pzfreo/purfel/stl/lower_sleeve.stl

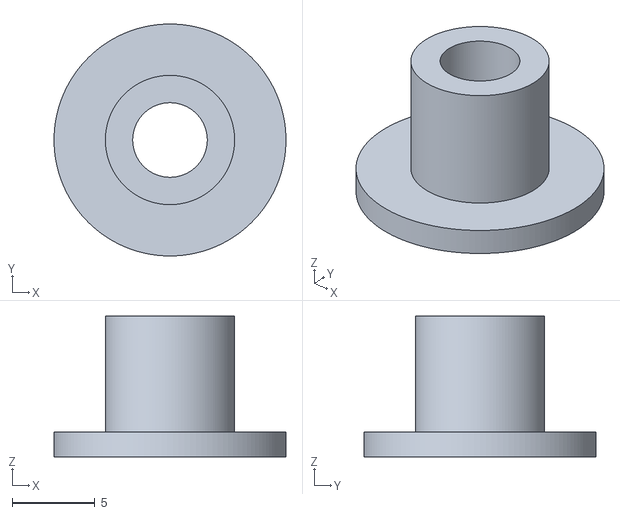
[picture p1: CAD file, 2026-04-23]
stl/lower_sleeve.stl
14.0 x 14.0 x 8.50
