pzfreo/purfel/stl/shoe.stl

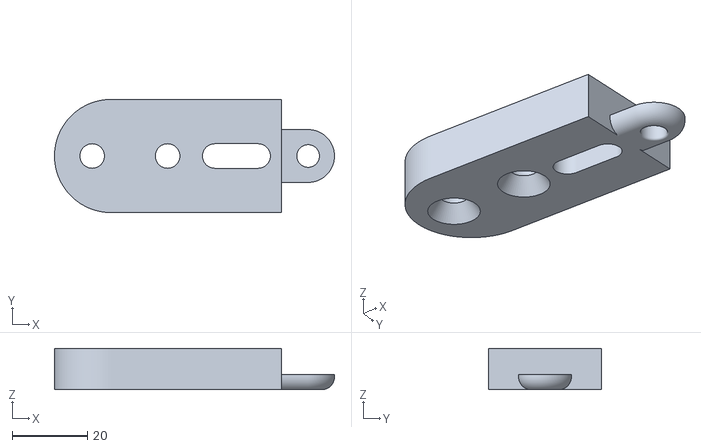
[picture p2: CAD file, 2026-04-23]
stl/shoe.stl
74.2 x 30.0 x 11.0
