pzfreo/purfel/stl/standoff.stl

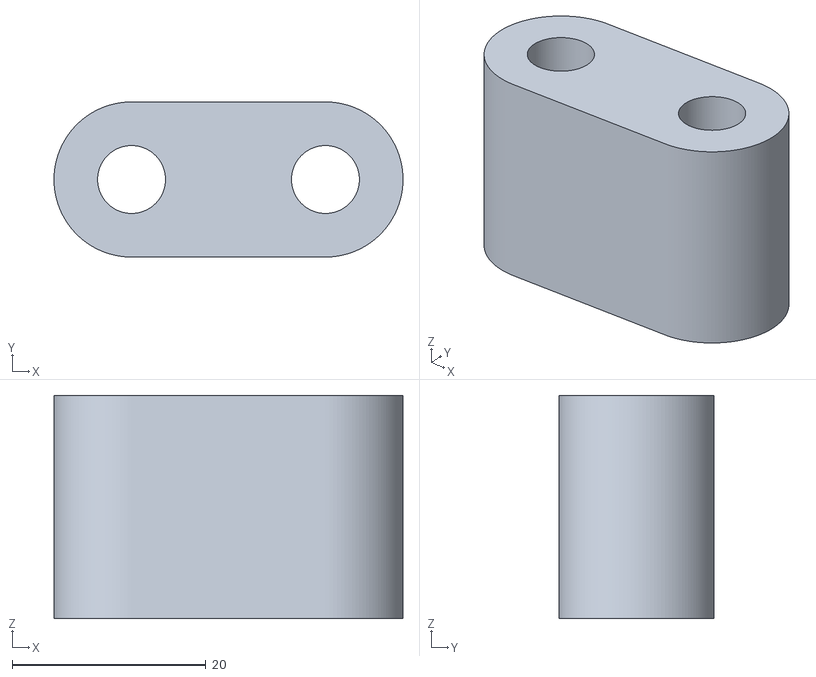
[picture p3: CAD file, 2026-04-23]
stl/standoff.stl
36.0 x 16.0 x 23.0
