pzfreo/purfel/stl/plate.stl

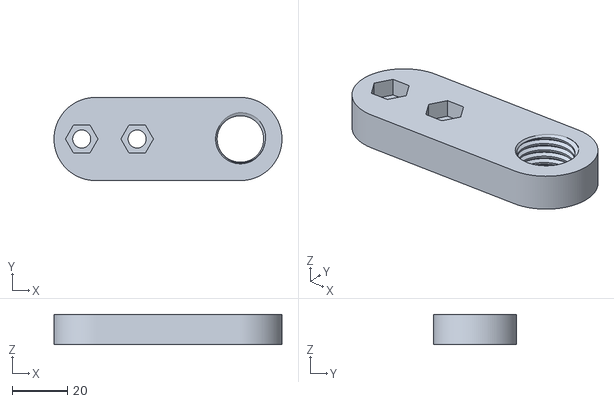
[picture p4: CAD file, 2026-04-23]
stl/plate.stl
82.2 x 30.0 x 11.0
