pzfreo/purfel/stl/upper_sleeve.stl

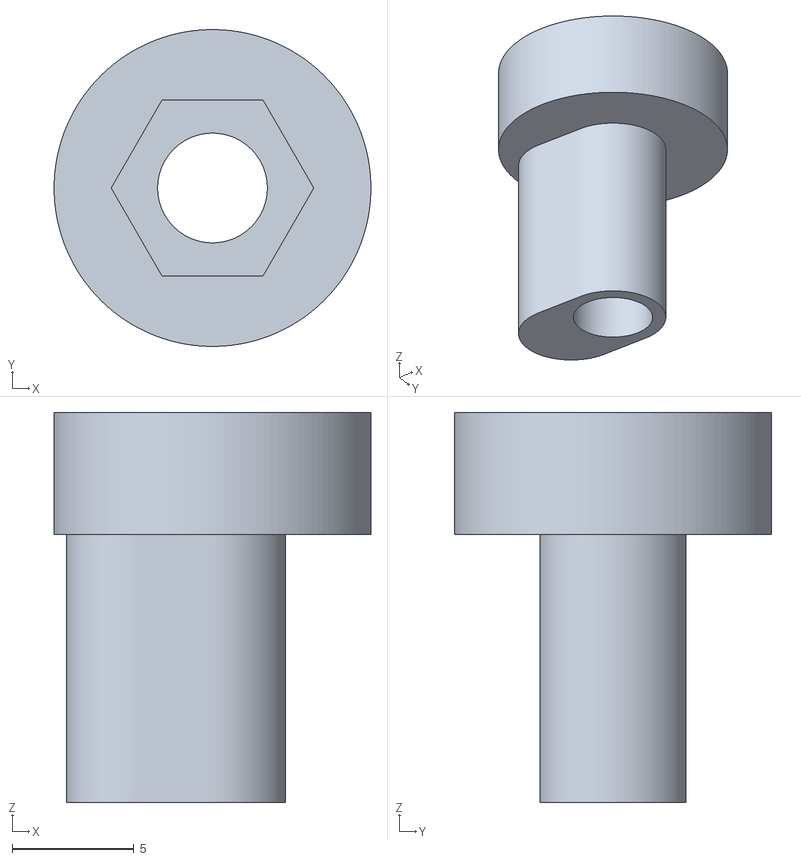
[picture p5: CAD file, 2026-04-23]
stl/upper_sleeve.stl
13.0 x 13.0 x 16.0
