pzfreo/purfel/stl/washer.stl

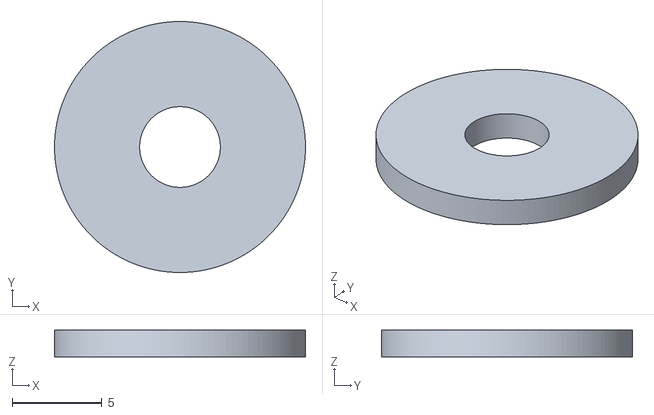
[picture p6: CAD file, 2026-04-23]
stl/washer.stl
14.0 x 14.0 x 1.50
