pzfreo/purfel/(commit log)

2026-04-22 Redesign as plate + shoe + two-part bearing sleeve
    The v0.1 base was a 50 mm tall pedestal with a fixed bearing position; you
    had to reprint to change the bit-to-bearing distance. The new low shoe sits
    on the work at z=0 and lets the bearing housing slide in a through-thickness
    slot, locked by an M4 bolt that comes up from below into an M4 heat-set
    insert in a new upper sleeve. A separate lower sleeve captures the bearing
    from underneath.
    - Replace build_base() with build_shoe() (pill profile, ~90x30x8 mm,
    centerline layout: bit hole at front, slot in middle, two M5 standoff
    bolt holes at back).
    - Replace build_sleeve() with build_upper_sleeve() and build_lower_sleeve().
    Upper top fla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
2026-04-22 Add SPEC.md and CLAUDE.md keeping spec/code in lockstep
    SPEC.md is the as-built design doc for v0.2 (plate + shoe + two-part
    sleeve). CLAUDE.md tells future sessions to update SPEC.md and
    cutter.py together so they don't drift.
2026-04-22 Narrow bearing channel and bring it within 2 mm of bit center
    - SLOT_W 8.5 → 6.5; UPPER_STEM1_D 8 → 6 (matches narrower stem).
    - SURROUND_LEN 22 → 14 and END_WALL_FRONT 6 → 3, shifting the slot
    toward the surround. At max-forward, the bearing's outer edge sits
    exactly 2 mm from the bit centerline. SHOE_L drops 89.75 → 78.75.
    - M4 insert can no longer fit in the now-Ø6 Stem 1, so move it into
    the top flange and grow UPPER_TOP_FLANGE_T 3 → 9. Stem 1 is now
    just M4 bolt clearance.
    - SPEC.md updated in lockstep per CLAUDE.md.
2026-04-22 Stadium slot, surround boss, M4 nut in shorter top flange
    Three coupled changes:
    - Bearing channel changed from a Box to a stadium-shaped SlotOverall
    extrusion (no sharp internal corners; X adjustment range unchanged).
    - Router bit surround replaced by a small Ø16 boss, height 4 mm. The
    shoe BODY is raised to z=SURROUND_HEIGHT (=4) and floats above the
    work; only the boss touches the workpiece. Knock-on: bearing top
    moves from z=-1.5 to z=2.5, with 4.5 mm of bearing OD remaining
    below z=0 to roll on the work edge.
    - M4 heat-set insert replaced by a captive M4 hex nut (7 mm AF, 3.2
    thick) embedded in a hex pocket inside the upper sleeve top flange.
    Top flange shrinks 9 -> 5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
2026-04-22 Redesign shoe surround, upper/lower sleeves (v0.3)
    Shoe: surround region is now subtractive — the front is cut to a Ø16×4mm
    snout that is the only contact patch. Shoe body sits flat at z=0–8 with no
    raised base.
    Upper sleeve: simplified to Stem 1 (in slot) + top flange only. Hex nut
    pocket now opens upward so the nut drops in from the top. Thrust step and
    bore stem moved off the upper sleeve (they were wider than the slot and
    couldn't be assembled).
    Lower sleeve: gains the bore stem (full BEARING_THK = 7mm, was 3.5mm) and
    an upper step (Ø14×1.5mm) that contacts the shoe bottom from below and
    rests on the bearing inner race top. Bottom flange retained.
    Assembly preview z-offsets up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
2026-04-22 Split lower sleeve step into separate washer; half-stadium snout (v0.4)
    Washer: the thrust step is now a separate flat ring (Ø14 × 1.5 mm, M4
    clearance). This makes assembly possible — the bearing slides freely onto
    the lower sleeve bore stem from above, then the washer is placed on the
    bearing inner race before the assembly is raised into the shoe slot.
    Half-stadium snout: the surround snout changes from a full circle (Ø16)
    to a half-stadium shape (flat back, Ø16 semicircular front). The flat back
    face is the full 16 mm width at the junction with the shoe body, giving
    roughly double the connection area compared to the tangent-line join of a
    circular snout. No new constants — rectan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
2026-04-22 Replace standoffs with M6 flat-head bolts; update plate and shoe (v0.5)
    Plate: removed longitudinal channel (obsolete). Thickened to PLATE_T=11 to
    accept 10 mm long inserts with 1 mm base. Extended to PLATE_L=100 (from 90)
    so the outer M6 insert hole has ≥6 mm wall. Added two M6 heat-set insert
    holes (Ø7.7 × 10 mm, entry chamfer) on the plate bottom face; positions
    derived from shoe standoff X coords via plate-shoe alignment offset.
    Shoe: standoff holes changed from M5 clearance cylinders to M6 flat-head
    countersinks (Ø12 × 4 mm cone from shoe bottom, narrowing to Ø6.5 shank
    clearance above). Added Cone import from build123d. SLOT_END_WALL increased
    3→6 mm and END_WALL_BACK increas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
2026-04-22 Make plate insert holes through-plate
    Changed from M6_INSERT_L (10 mm) depth to full PLATE_T (11 mm) so the
    bolt can pass cleanly through without a blind-hole stop.
2026-04-22 Add estampo slicing pipeline (OrcaSlicer, Bambu P1S, PETG-CF)
    estampo.toml: load → arrange → plate → slice → pack pipeline for all five
    STEP parts. Printer: Bambu Lab P1S 0.4 nozzle. Process: 0.20mm Strength
    @BBL X1C. Filament: Bambu PETG-CF @BBL X1C 0.4 nozzle. Overrides set 5
    walls, 40% gyroid infill, 6 top/bottom layers, and xy_hole_compensation
    = 0.1 for bearing-bore and slot dimensional accuracy. Pack stage uses
    bambox repack to produce .gcode.3mf for Bambu Connect.
    .github/workflows/slice.yml: builds STEP files (uv run python cutter.py)
    then runs the full estampo pipeline on every push; posts print metrics as
    a PR comment.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
2026-04-22 estampo: flip upper_sleeve, add PETG-CF settings and 8mm brim
    upper_sleeve: orient upside-down so the Ø15 flange face is on the bed and
    the stem prints as a clean tower from a stable base.
    Overrides added:
    - fan_max_speed = 40 and close_fan_the_first_x_layers = 3: PETG-CF bonds
    better with less cooling; also guards first-layer adhesion.
    - outer_wall_speed = 40: slower outer wall improves roundness on the
    bearing bore and sleeve slot (sliding-fit surfaces).
    - brim_type = outer_only, brim_width = 8: adhesion for the narrow sleeve
    stem and the small-footprint washer.
2026-04-22 Fillet outer bottom perimeter of surround snout (r=1 mm)
    No sharp corners where the snout contacts the workpiece. Keeps the
    bit hole edge and the rect's back edge (which meets the main shoe
    body) unfilleted — filter on z=0 + x > surround_x_start, and
    exclude circles with radius < SURROUND_BOSS_D/2 to skip the bit hole.
    Verified locally with `uv run --script cutter.py`.
2026-04-22 Max outer fillet (r=3.4 mm) + 0.5 mm bit-hole inner fillet
    Outer radius pushed from 1.0 → 3.4 mm — the geometric limit set by
    SURROUND_WALL (4) minus bit hole radius (4 − 4 = 0 at the cap
    pinch-point), minus the 0.5 mm inner fillet, minus a 0.1 mm margin
    for boolean stability. Adds a 0.5 mm fillet on the bit hole bottom
    edge so bit entry has no sharp lip.
    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
2026-04-22 Reduce bit hole to Ø6 mm; snout shrinks to 14×14 mm
    BIT_HOLE_D: 8 → 6 mm. SURROUND_BOSS_D follows automatically (6 + 2×4
    wall = 14 mm, was 16 mm). Snout footprint is now 14 mm wide × 14 mm
    tip-to-back (was 16×15). Fillet limits unchanged (wall thickness = 4 mm
    throughout). Hole remains centred at SURROUND_X under the Dremel bore.
2026-04-22 Weld snout to shoe body so it prints as a single solid
    The front cut subtracted body material with a 0.1 mm tolerance
    (surround_x_start - 0.1), but the snout rect and cylinder started
    exactly at surround_x_start. That left a 0.1 mm gap; the shoe
    exported as two disjoint solids and the slicer printed the snout
    as a separate part that broke off under pressure.
    Extend the snout rectangle back by a new SURROUND_OVERLAP = 2 mm
    into the remaining shoe body so the boolean union is a real weld.
    shoe.solids() now returns 1 (was 2).
2026-04-22 Halve SLOT_LEN (30 → 15) to shorten the bit-to-bolt cantilever
    The bearing slot sits directly between the inner standoff bolt and
    the bit, so every mm of slot adds a mm of moment arm on the plate.
    Router depth was flexing at max inset; shrinking the slot brings
    the inner bolt closer to the bit and stiffens the assembly.
    New geometry:
    - bearing-edge to bit-edge gap: 1.25 – 10.25 mm (was 1.25 – 25.25)
    - cantilever (inner bolt → bit center): 34.25 mm (was 49.25)
    - SHOE_L: 71.25 mm (was 86.25); 15 mm less plastic per print
    Min gap is unchanged (fixed by END_WALL_FRONT and SURROUND_LEN).
    The 1.5 – 10 mm working range requested fits inside 1.25 – 10.25.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
2026-04-23 Stadium upper sleeve, SLOT_LEN 18 mm, parametric plate length (#6)
    * Stadium upper sleeve, SLOT_LEN 18 mm, parametric plate length
    Three related changes:
    1. Upper sleeve stem: circle → 9×6 mm stadium (SlotOverall).
    Flat sides key into the slot walls and block rotation when the
    bearing bolt is tightened or loosened. Minimum Y-width stays 6 mm;
    M4 hole centred in the stadium (1.5 mm from each flat end).
    Adjustment range unchanged at 8.5 mm total (longer slot compensates).
    2. SLOT_LEN 15 → 18 mm. Bearing-edge-to-bit gap now 1.25–13.25 mm;
    cantilever grows to 37.25 mm. Shoe grows to 74.25 mm.
    3. PLATE_L made parametric: derived from shoe standoff span so the
    plate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
2026-04-23 Make standoff width parametric to avoid overhang and sleeve clash (#7)
    * Make standoff width parametric to avoid overhang and sleeve clash
    STANDOFF_W is now derived from the tightest geometric constraint rather
    than a fixed wall target. It takes the smaller of:
    (a) flush with the shoe back wall
    (b) clear of the upper sleeve top flange
    then subtracts STANDOFF_CLEARANCE=2 mm (1 mm each end).
    Result: 22.5 → 18 mm, wall ≈ 5.75 mm each side. The standoff will
    always stay within the shoe footprint and clear the sleeve flange even
    if slot length or standoff span change.
    * Offset upper sleeve stadium so hole sits at bit-side cap c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
2026-04-23 Fix upper-sleeve/standoff interference at max bearing distance; shrink flange (#8)
    The STANDOFF_W flange-limit formula used SLOT_X_CENTER (slot midpoint) as
    the bearing reference, but the bearing can slide 4.25 mm further toward −X
    (until the inner stem cap aligns with the outer slot cap). At that extreme
    position the upper-sleeve flange overlapped the standoff by 1 mm.
    Fix: introduce BEARING_X_MIN (the worst-case bearing X position) and use it
    in the flange-limit formula instead of SLOT_X_CENTER. STANDOFF_W is now
    parametrically correct for the full range of bearing travel.
    Also reduce UPPER_TOP_FLANGE_D 15 → 13 mm. The M4 nut pocket needs ~4.2 mm
    circumradius; 13 mm gives 2.3 mm wall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
2026-04-23 Add standoff to estampo, fix slice action PR comments, raise wall loops to 6 (#9)
    - estampo.toml: add standoff.step as an upright part so it gets sliced
    - estampo.toml: wall_loops 5 → 6 for extra perimeter strength
    - slice.yml: change trigger from bare push to push-to-main + pull_request;
    the bare push event carries no PR number so the Estampo action had nowhere
    to post its comment
2026-04-23 Increase PLATE_T and SHOE_T to 11 mm; add stl/ output directory (#10)
    Both parts were 10 mm and 8 mm respectively. Bumped to 11 mm for extra
    rigidity. STLs now also written to stl/ (not gitignored) so printable
    files are committed alongside the source.
    [lower_sleeve.stl, plate.stl, shoe.stl, standoff.stl, upper_sleeve.stl, washer.stl]
